alf45tar/Curtain-ESP-DMX/(commit log)

2026-05-12 Add initial implementation of ESP-DMX for DMX control of curtain motors
2026-05-12 Add power-saving feature by setting direction pin to LOW when stopped
2026-05-13 Refactor safe startup procedure to apply motion stop instead of enabling motor output
2026-05-24 Update README with improved wiring diagram and compile instructions
2026-05-24 Enhance README with emoji headers, correct typos, and add new sections for wireless control and configuration
2026-05-29 Update README to clarify power supply specifications and DMX connector usage
2026-06-18 Use separate open and close relay pins with 100 ms stop pulse on both
